Lc2007081623/jr-controller/installer/hikari.png

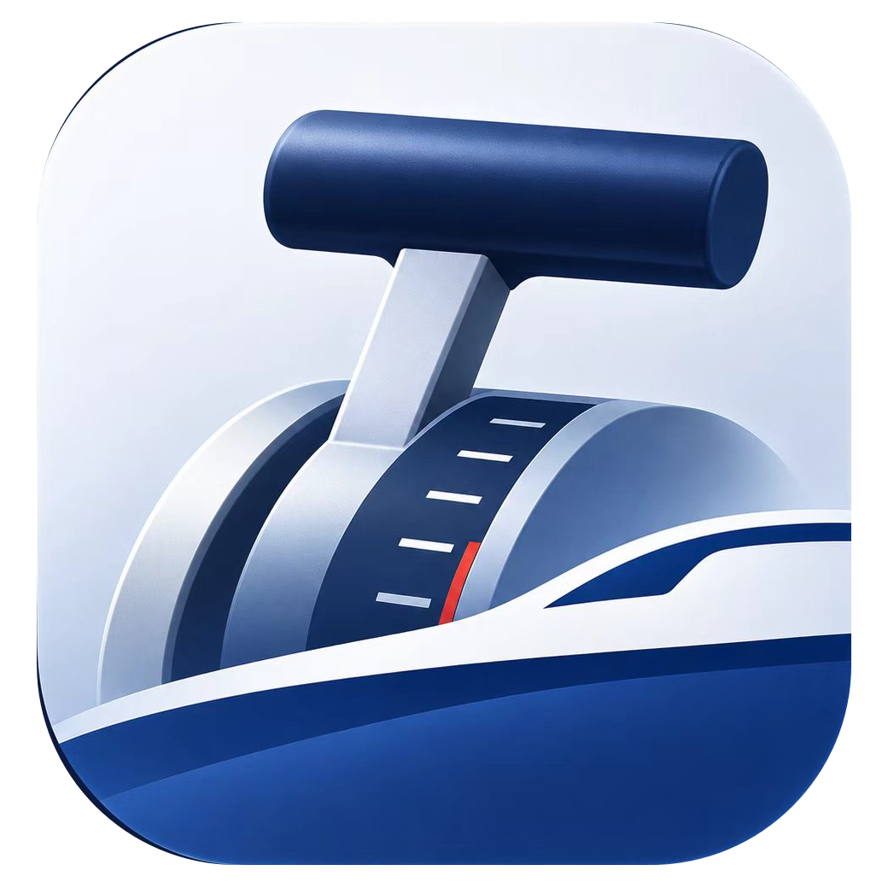
installer/hikari.png
