Lc2007081623/jr-controller/hardware/schematic_images/README.md

# 嘉立创 EDA 原理图录入参考 · A1

日期：2026-10-18。交付为五张 3200×2200 PNG，附同名 SVG。按用户要求不生成 KiCad 工程。

1. `01_主控排针.png`：主控板两列候选排母及网络分配。
2. `02_电源与模拟采样.png`：显示5V输入、载板3.3V去耦、主/备用电位器输入。
3. `03_MAX7219电平转换.png`：SN74AHCT125D全部引脚、五信号显示接口。
4. `04_十二路按钮.png`：12套独立上拉、串联电阻与面板接口。
5. `05_换向与辅助输入.png`：换向、EB触点、本地校准及测试点。

相同蓝色网络名在不同页直接互连，GND为公共地。网络名必须逐字一致；跨页录入时使用全局网络标签。图中芯片按完整14脚矩形表示，嘉立创器件库可使用分门符号，但全部电源、使能和未用引脚仍需连接。

本版供电：主控由板上原生USB供电；显示与电平转换器从J90输入独立稳定5V；两者仅共地。J1.21（主控5Vin）明确留空。载板不连接电脑USB VBUS与独立显示5V，不短接主控IN-OUT或USB-OTG焊盘。若后续需要整机单USB供电，须先核对实物电源路径后修改图纸。

J1/J2针序依据YD系列参考，用户板型号/版本和排针尺寸尚未核对：不要据此直接定PCB封装或下单。J5是载板自定义五信号针序，MAX7219模块的实际输入排列要另行核对。当前电位器为用户选定的RK097N B10K三脚款，图中用电阻轨端/滑动端说明接线。端子、封装与轴尺寸待到货测量，不套用原备选ALPS封装。

原理图图像和BOM中的R/C均以独立器件计数。未接的GPIO与预留连接器可以按需要省装，但不可更改已使用引脚编号。物理常开按钮、电位器和MAX7219模块属于线束外设；BOM列出载板器件，外设另购。

`BOM.csv`是录入器件清单，`connections.csv`是逐引脚网络对照。生成脚本执行了关键连接断言，但这些不是EDA原生ERC，录入后仍需在嘉立创运行电气检查，复核连接器封装与芯片脚号。当前S3固件和硬件链路尚未验证；PC虚拟XInput已验证游戏P1/P3/B5，详见项目README与技术总结。

来源：

- [YD系列厂家参考排针](https://github.com/vcc-gnd/YD-ESP32-S3)
- [SN74AHCT125原厂引脚与电气要求](https://www.ti.com/lit/ds/symlink/sn74ahct125.pdf)
- [MAX7219原厂供电与接口](https://www.analog.com/media/en/technical-documentation/data-sheets/MAX7219-MAX7221.pdf)
- 当前RK097N参数来源：用户提供的B10K三脚款商品截图，阻值与线性需实测。
- 原备选 [ALPS RK09L1120A5F](https://tech.alpsalpine.com/e/products/detail/RK09L1120A5F/)

A1变更：仅更换第一版电位器型号与端子核对说明，4.7kΩ、1kΩ、100nF与GPIO1网络保持不变。商品标注约300°机械角和15mm轴长，不能代替实物尺寸；起止ADC值与N位置均须重新校准。
