Lc2007081623/jr-controller/docs/第一版验收记录.md

# 第一版验收记录

日期：2026-10-21。

Git版本：`v0.1.0`（第一版功能验证）。

用户先确认主档位正常；换向改用XInput X轴并重新加载桥接后，用户确认“验证成功，第一版结束”。记录为第一版功能链路通过，机械回差仍待解决。

## 当前配置

| 项目 | 第一版状态 |
| --- | --- |
| 主控 | 现有ESP32-S3 N16R8板 |
| 电位器 | RK097N B10K，滑动端GPIO3，两端3V3/GND |
| 点阵 | 单块MAX7219，DIN6、CS5、CLK4，沿用已验证供电接线 |
| 显示规则 | 牵引数字；制动数字加右下角LED；空挡N；紧急制动E |
| 校准 | 15点实测，NVS保存；最小相邻间隔12，保留迟滞 |
| 换向按钮 | GPIO10对地，内部上拉，30ms消抖 |
| PC出口 | 同一虚拟Xbox手柄：Y轴主档位，X轴锁存前进F |
| 启用条件 | 连接串口、创建虚拟手柄，物理N后手动启用 |
| 软件验证 | 22项自动测试通过；用户确认游戏档位与换向运行成功 |

默认固件环境为 `s3_uart`；当前临时硬件接线与载板参考图不同，以本记录及[验证步骤](点阵与GPIO3验证.md)为准。本次收尾只更新文档，保留当前程序和设备参数。

## 历史遗留问题：机械回差（已解决）

2026-10-24后续更新：AS5600接入后，用户明确确认机械回差问题已经解决。以下保留第一版结束时的问题与排查计划，不再作为当前待办。

已报告现象：从EB回到空挡，与从P5回到空挡时，ADC读数不同。用户确认机械回差问题仍存在。

后续先记录两个方向回N、停稳后的RAW/ADC和重复性，再检查电位器轴连接间隙、固定与空挡定位。具体间隙来源、停稳后的差值，以及是否需调整空挡识别区间尚未确认。本次没有通过扩大软件空挡区间掩盖该问题。

第一版完成不表示PCB生产文件、全部外设、其他车型或所有异常工况均已验收；各项仍按原有记录保留验证范围。
