Lc2007081623/jr-controller/docs/换向输入核对.md

# 换向输入核对：2026-10-21

用户已经确认电位器主档位正常，GPIO10换向异常。此前将GPIO10映射为键盘↑没有实测通过。现在PC桥接改成同一XInput手柄的左摇杆X轴，Y轴继续保留原档位映射。

## 本地静态观察

目标为用户游戏目录中的 `JREAST_TrainSimulator.exe`，SHA256：`7d04aca24bf4ce2c118afd7861be2f4e6308b0403138325e82b002ae37bb0706`。

以下来自既有反汇编以及本次本地PE/Capstone只读检查，不是REA Evidence。当前没有连接REA工具；其CLI doctor又因包内依赖 `@modelcontextprotocol/client/dist/index.mjs` 缺失而失败，未改客户端配置或游戏文件。

- `0x14008121b`读取XInput状态左摇杆X，归一化后置于xmm1；`0x140081223`读取Y，归一化后置于xmm0，`0x14008124b`调用`0x14007dbc0`。
- 转换器在`0x14007dbfc`保留xmm1，在`0x14007dbff`保留xmm0。后续Y分支正是原有牵引/制动分档。
- `0x14007e328`开始比较X，原厂静态阈值为+0.9与-0.9；跨正阈值生成+1，跨负阈值生成-1，中央生成0。
- `0x14007e36a`至`0x14007e37a`把该值写入输入项7。该分支还更新内部方向键状态0x64/0x65与0x1f0/0x1f1。
- 另一个设备路径`0x140081be0`至`0x140081c4a`把同一方向状态转换为+1、-1、0，并写入同一输入项7。

据此，修正方案通过原生X轴保持换向请求，而非混合键盘事件。当前选择F=+32767，N=0。后续用户确认修正后验证成功，作为运行验证记录；上述静态观察本身不代替运行验证。

## 实现和验证范围

GPIO10固件不变：内部上拉、30ms消抖、按下计数。PC只接受已启用、物理N、新鲜的单次按下；F会锁存并与每次Y报告合并，避免每次改档又把X清零。停止输出、超时或关闭时复位双轴。

自动测试覆盖全部15档下F保持、改换向不扰动主档位、停止/关闭复位、按钮不连发、旧事件不补发。22项测试通过；游戏换向效果由用户实测后确认成功。
