Lc2007081623/jr-controller/hardware/schematic_images/01_主控排针.png

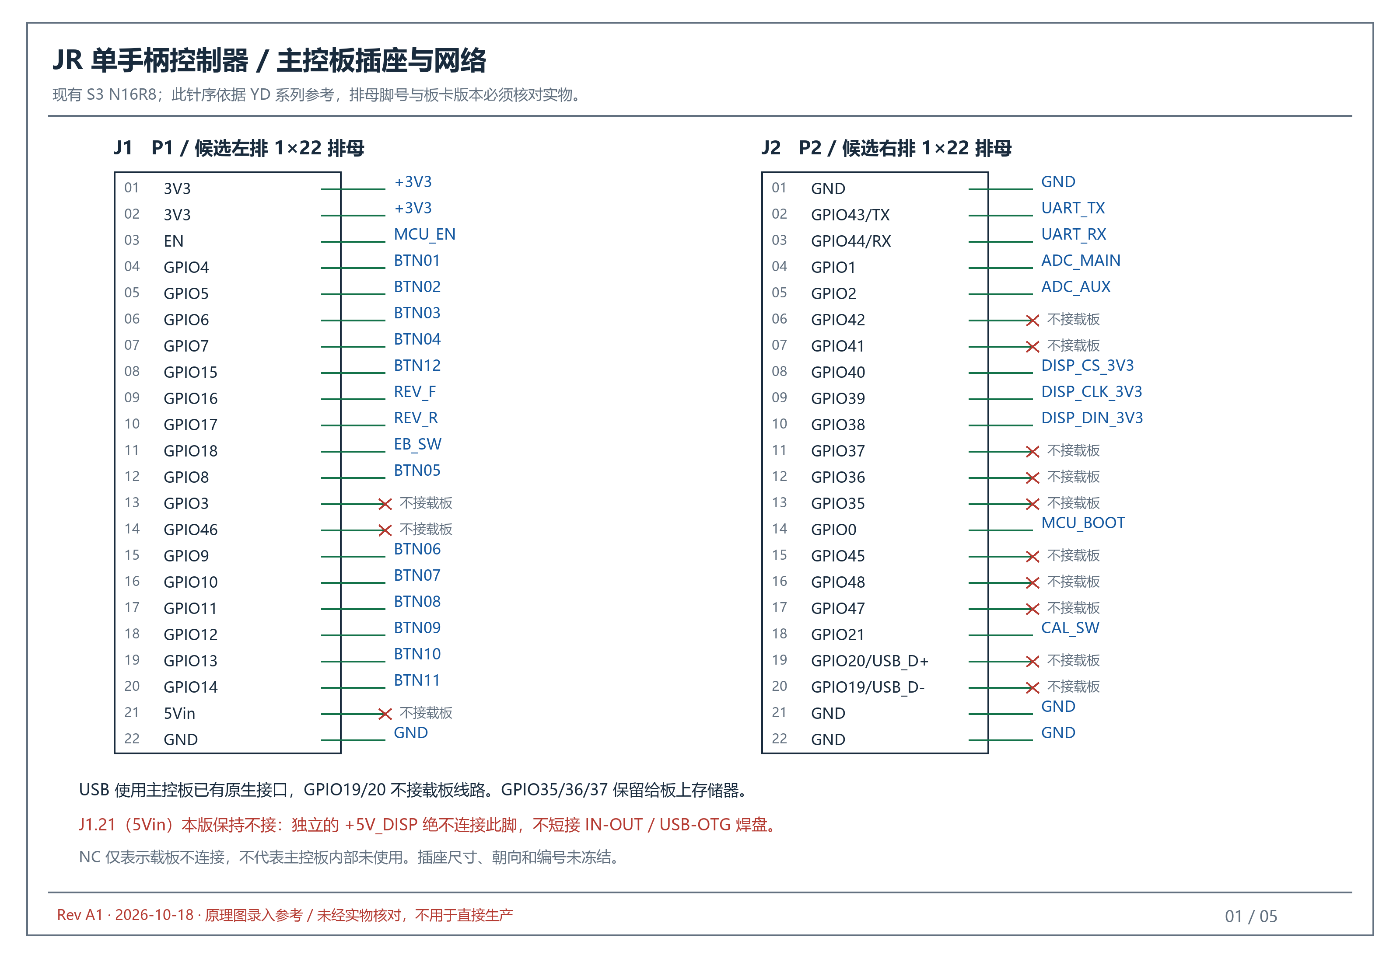
hardware/schematic_images/01_主控排针.png
