Lc2007081623/jr-controller/hardware/schematic_images/02_电源与模拟采样.png

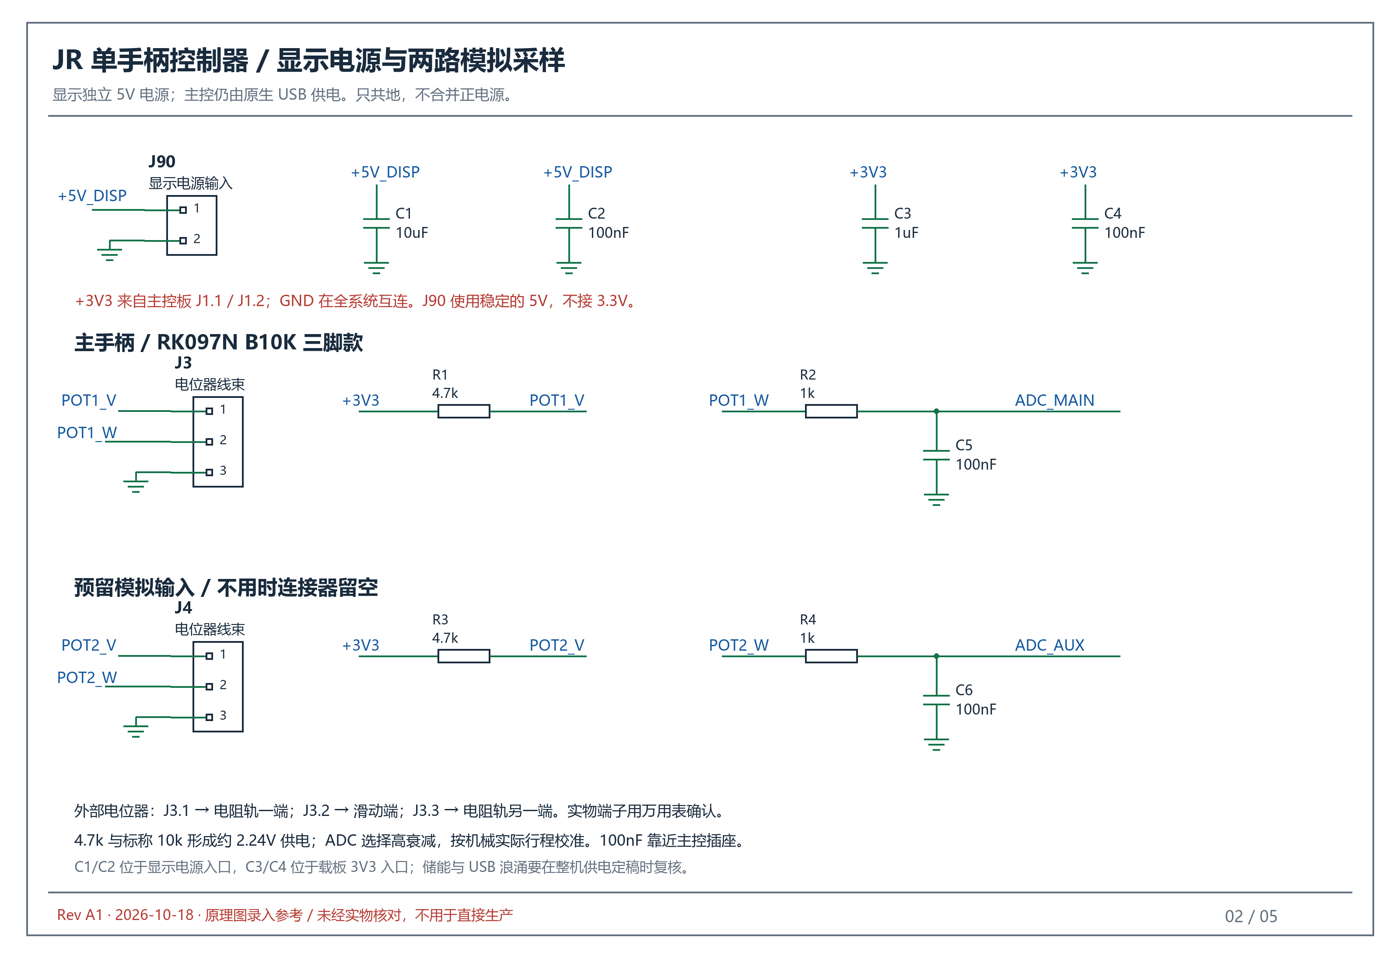
hardware/schematic_images/02_电源与模拟采样.png
