Lc2007081623/jr-controller/hardware/schematic_images/03_MAX7219电平转换.png

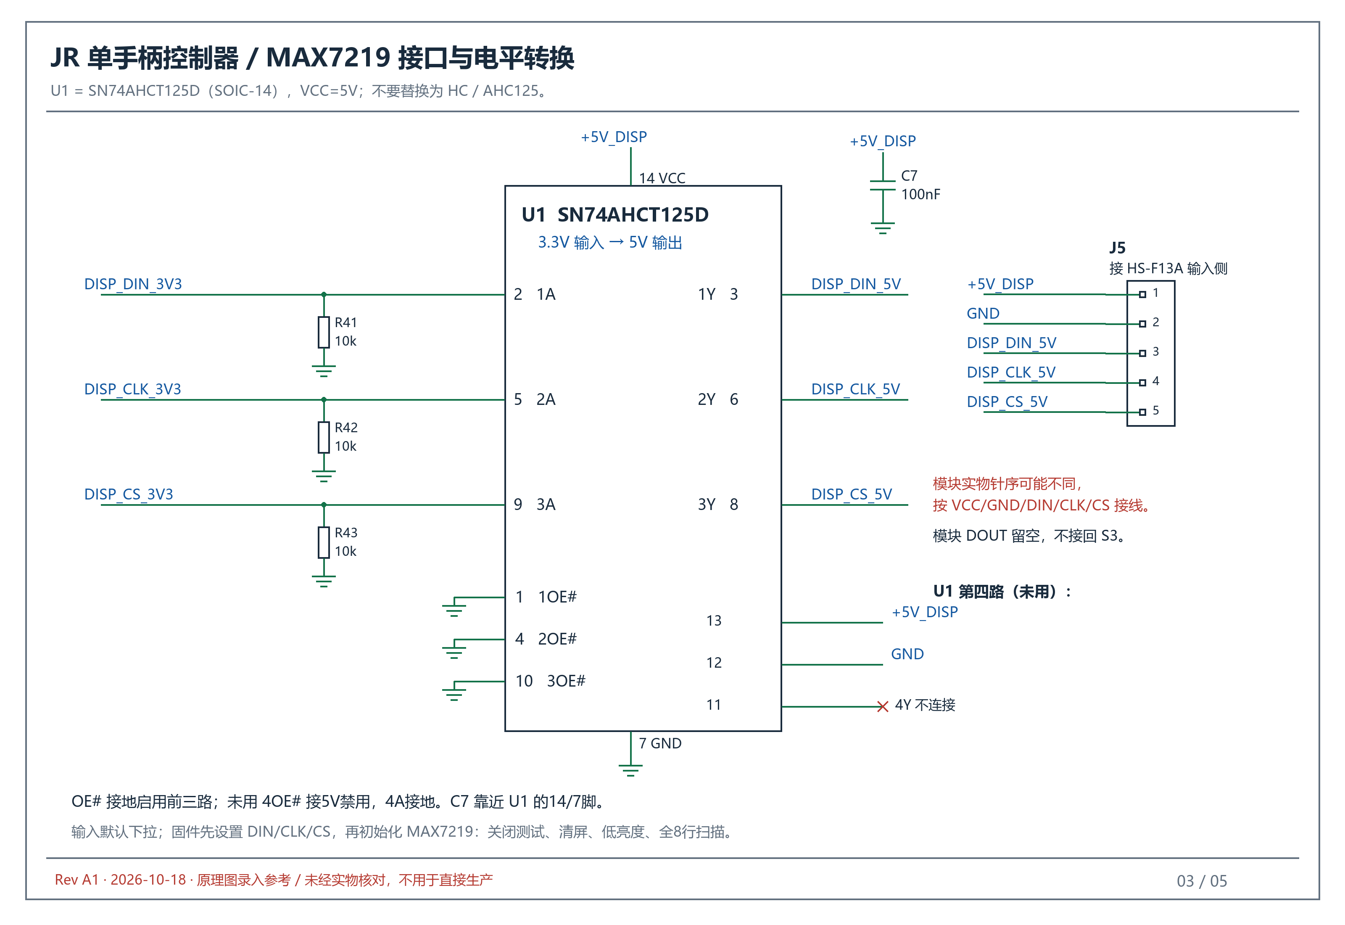
hardware/schematic_images/03_MAX7219电平转换.png
