Lc2007081623/jr-controller/hardware/schematic_images/04_十二路按钮.png

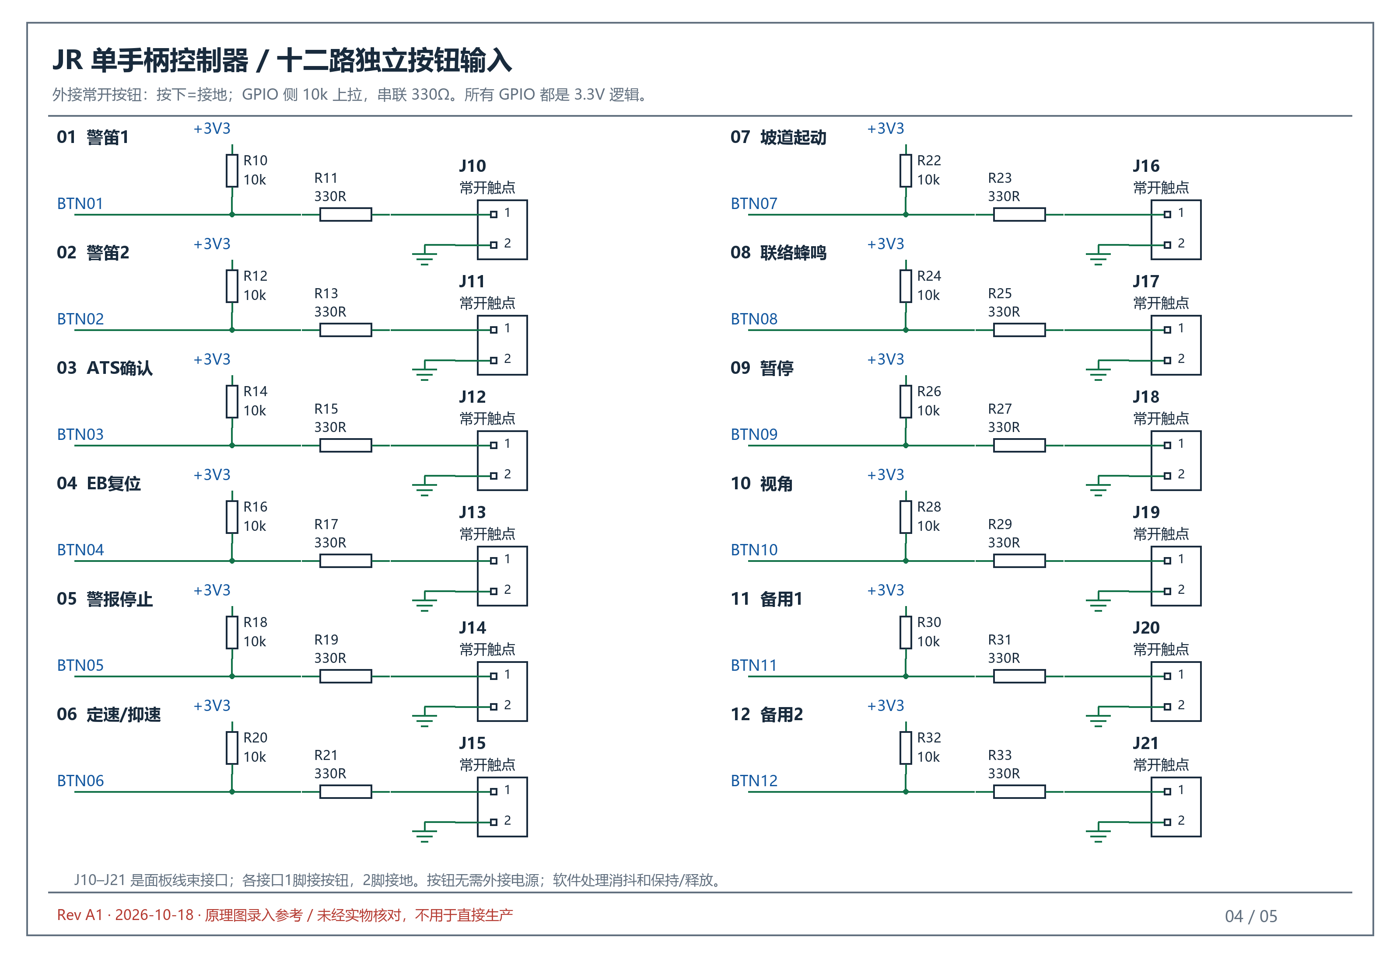
hardware/schematic_images/04_十二路按钮.png
