Lc2007081623/jr-controller/hardware/schematic_images/05_换向与辅助输入.png

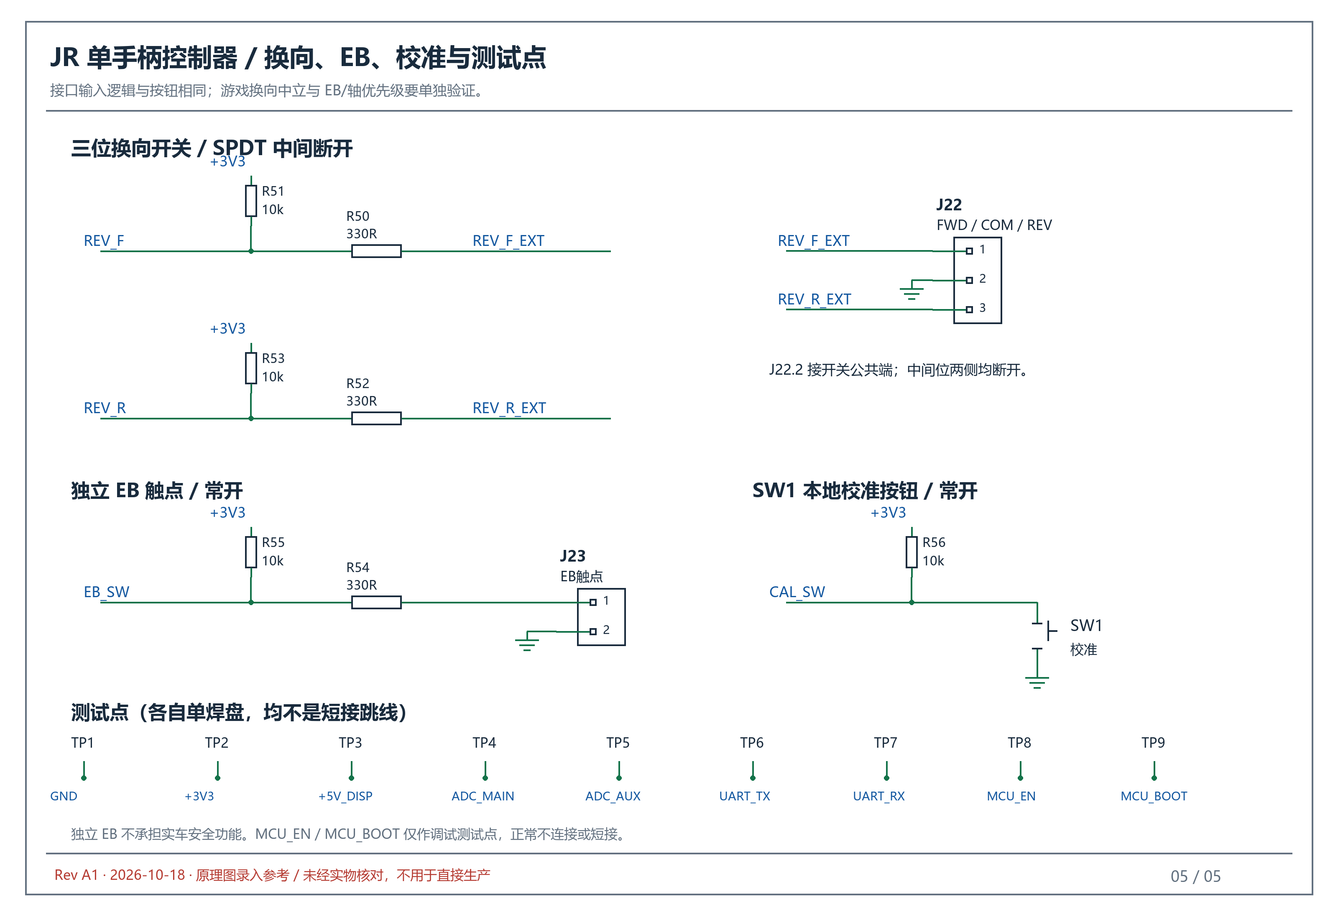
hardware/schematic_images/05_换向与辅助输入.png
