Lc2007081623/jr-controller/hardware/schematic_images/connections.csv

Reference | Pin | Net
J1 | 1 | +3V3
J1 | 2 | +3V3
J1 | 3 | MCU_EN
J1 | 4 | BTN01
J1 | 5 | BTN02
J1 | 6 | BTN03
J1 | 7 | BTN04
J1 | 8 | BTN12
J1 | 9 | REV_F
J1 | 10 | REV_R
J1 | 11 | EB_SW
J1 | 12 | BTN05
J1 | 13 | NC
J1 | 14 | NC
J1 | 15 | BTN06
J1 | 16 | BTN07
J1 | 17 | BTN08
J1 | 18 | BTN09
J1 | 19 | BTN10
J1 | 20 | BTN11
J1 | 21 | NC
J1 | 22 | GND
J2 | 1 | GND
J2 | 2 | UART_TX
J2 | 3 | UART_RX
J2 | 4 | ADC_MAIN
J2 | 5 | ADC_AUX
J2 | 6 | NC
J2 | 7 | NC
J2 | 8 | DISP_CS_3V3
J2 | 9 | DISP_CLK_3V3
J2 | 10 | DISP_DIN_3V3
J2 | 11 | NC
J2 | 12 | NC
J2 | 13 | NC
J2 | 14 | MCU_BOOT
J2 | 15 | NC
J2 | 16 | NC
J2 | 17 | NC
J2 | 18 | CAL_SW
J2 | 19 | NC
J2 | 20 | NC
J2 | 21 | GND
J2 | 22 | GND
J90 | 1 | +5V_DISP
J90 | 2 | GND
C1 | 1 | +5V_DISP
C1 | 2 | GND
C2 | 1 | +5V_DISP
C2 | 2 | GND
C3 | 1 | +3V3
C3 | 2 | GND
C4 | 1 | +3V3
C4 | 2 | GND
J3 | 1 | POT1_V
J3 | 2 | POT1_W
J3 | 3 | GND
R1 | 1 | +3V3
R1 | 2 | POT1_V
R2 | 1 | POT1_W
R2 | 2 | ADC_MAIN
C5 | 1 | ADC_MAIN
C5 | 2 | GND
J4 | 1 | POT2_V
J4 | 2 | POT2_W
J4 | 3 | GND
R3 | 1 | +3V3
R3 | 2 | POT2_V
R4 | 1 | POT2_W
R4 | 2 | ADC_AUX
C6 | 1 | ADC_AUX
C6 | 2 | GND
U1 | 2 | DISP_DIN_3V3
U1 | 3 | DISP_DIN_5V
R41 | 1 | DISP_DIN_3V3
R41 | 2 | GND
U1 | 5 | DISP_CLK_3V3
U1 | 6 | DISP_CLK_5V
R42 | 1 | DISP_CLK_3V3
R42 | 2 | GND
U1 | 9 | DISP_CS_3V3
U1 | 8 | DISP_CS_5V
R43 | 1 | DISP_CS_3V3
R43 | 2 | GND
U1 | 1 | GND
U1 | 4 | GND
U1 | 10 | GND
U1 | 14 | +5V_DISP
U1 | 7 | GND
C7 | 1 | +5V_DISP
C7 | 2 | GND
J5 | 1 | +5V_DISP
J5 | 2 | GND
J5 | 3 | DISP_DIN_5V
J5 | 4 | DISP_CLK_5V
J5 | 5 | DISP_CS_5V
U1 | 13 | +5V_DISP
U1 | 12 | GND
U1 | 11 | NC
R10 | 1 | +3V3
R10 | 2 | BTN01
R11 | 1 | BTN01
R11 | 2 | BTN01_EXT
J10 | 1 | BTN01_EXT
J10 | 2 | GND
R12 | 1 | +3V3
R12 | 2 | BTN02
R13 | 1 | BTN02
R13 | 2 | BTN02_EXT
J11 | 1 | BTN02_EXT
J11 | 2 | GND
R14 | 1 | +3V3
R14 | 2 | BTN03
R15 | 1 | BTN03
R15 | 2 | BTN03_EXT
J12 | 1 | BTN03_EXT
J12 | 2 | GND
R16 | 1 | +3V3
R16 | 2 | BTN04
R17 | 1 | BTN04
R17 | 2 | BTN04_EXT
J13 | 1 | BTN04_EXT
J13 | 2 | GND
R18 | 1 | +3V3
R18 | 2 | BTN05
R19 | 1 | BTN05
R19 | 2 | BTN05_EXT
J14 | 1 | BTN05_EXT
J14 | 2 | GND
R20 | 1 | +3V3
R20 | 2 | BTN06
R21 | 1 | BTN06
R21 | 2 | BTN06_EXT
J15 | 1 | BTN06_EXT
J15 | 2 | GND
R22 | 1 | +3V3
R22 | 2 | BTN07
R23 | 1 | BTN07
R23 | 2 | BTN07_EXT
J16 | 1 | BTN07_EXT
J16 | 2 | GND
R24 | 1 | +3V3
R24 | 2 | BTN08
R25 | 1 | BTN08
R25 | 2 | BTN08_EXT
J17 | 1 | BTN08_EXT
J17 | 2 | GND
R26 | 1 | +3V3
R26 | 2 | BTN09
R27 | 1 | BTN09
R27 | 2 | BTN09_EXT
J18 | 1 | BTN09_EXT
J18 | 2 | GND
R28 | 1 | +3V3
R28 | 2 | BTN10
R29 | 1 | BTN10
R29 | 2 | BTN10_EXT
J19 | 1 | BTN10_EXT
J19 | 2 | GND
R30 | 1 | +3V3
R30 | 2 | BTN11
R31 | 1 | BTN11
R31 | 2 | BTN11_EXT
J20 | 1 | BTN11_EXT
J20 | 2 | GND
R32 | 1 | +3V3
R32 | 2 | BTN12
R33 | 1 | BTN12
R33 | 2 | BTN12_EXT
J21 | 1 | BTN12_EXT
J21 | 2 | GND
R50 | 1 | REV_F
R50 | 2 | REV_F_EXT
R51 | 1 | +3V3
R51 | 2 | REV_F
J22 | 1 | REV_F_EXT
R52 | 1 | REV_R
R52 | 2 | REV_R_EXT
R53 | 1 | +3V3
R53 | 2 | REV_R
J22 | 3 | REV_R_EXT
J22 | 2 | GND
R54 | 1 | EB_SW
R54 | 2 | EB_EXT
R55 | 1 | +3V3
R55 | 2 | EB_SW
J23 | 1 | EB_EXT
J23 | 2 | GND
R56 | 1 | +3V3
R56 | 2 | CAL_SW
SW1 | 1 | CAL_SW
SW1 | 2 | GND
TP1 | 1 | GND
TP2 | 1 | +3V3
TP3 | 1 | +5V_DISP
TP4 | 1 | ADC_MAIN
TP5 | 1 | ADC_AUX
TP6 | 1 | UART_TX
TP7 | 1 | UART_RX
TP8 | 1 | MCU_EN
TP9 | 1 | MCU_BOOT
