Lc2007081623/jr-controller/装配体1.SLDASM

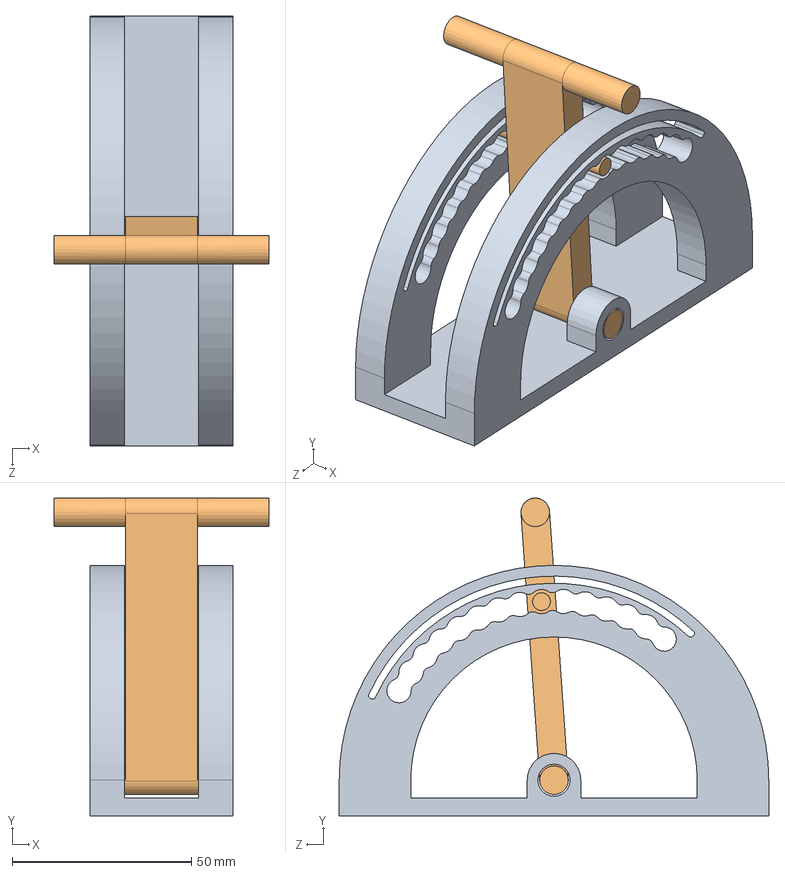
[picture p7: CAD file, 2026-10-14]
装配体1.SLDASM
60.0 x 88.8 x 120.0 mm
零件1
零件2^装配体1
