Lc2007081623/jr-controller/v2分度盘子.SLDPRT

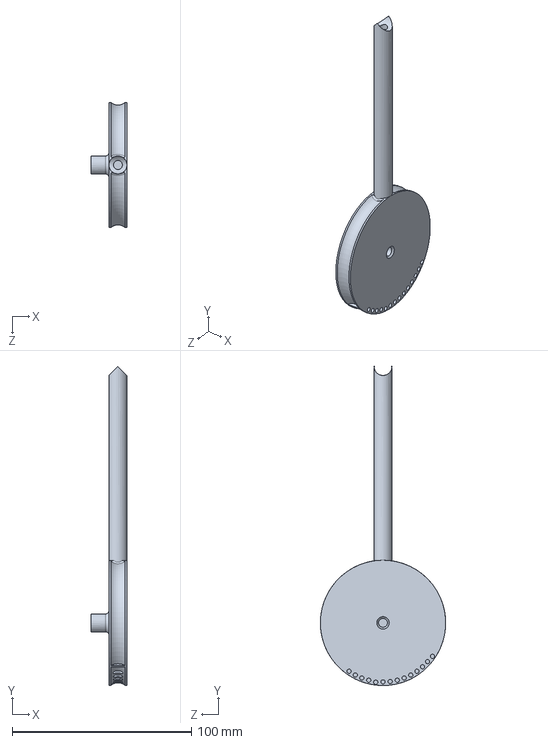
[picture p8: CAD file, 2026-10-24]
v2分度盘子.SLDPRT
20.0 x 178.2 x 70.0 mm
