Lc2007081623/jr-controller/基座.SLDPRT

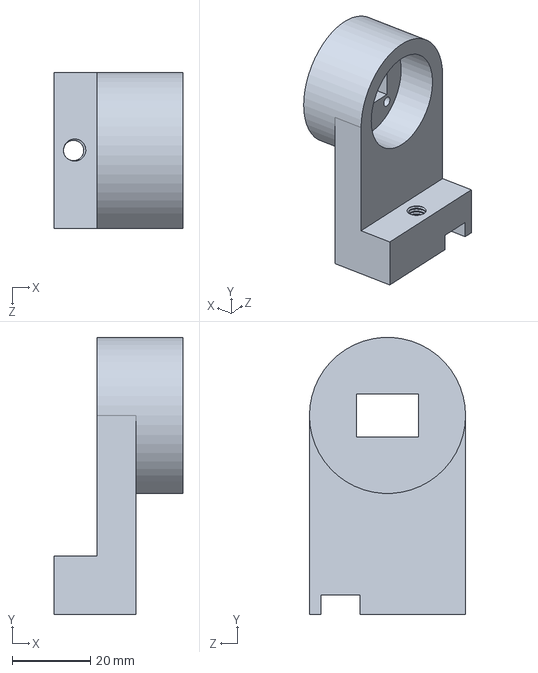
[picture p9: CAD file, 2026-10-24]
基座.SLDPRT
33.0 x 71.0 x 40.0 mm
