Lc2007081623/jr-controller/把手.SLDPRT

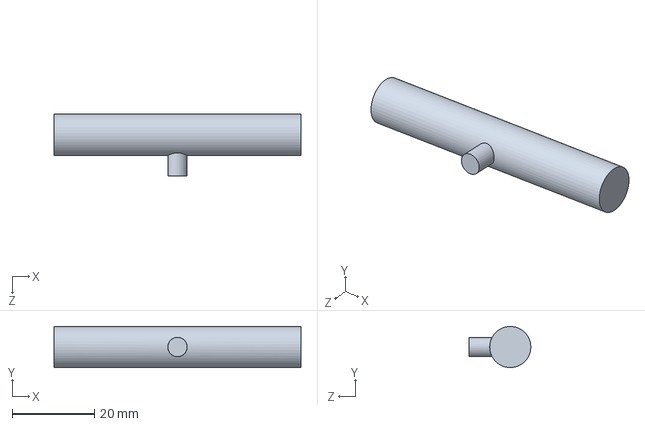
[picture p10: CAD file, 2026-10-24]
把手.SLDPRT
60.0 x 9.97 x 15.0 mm
