Lc2007081623/jr-controller/后挡.SLDPRT

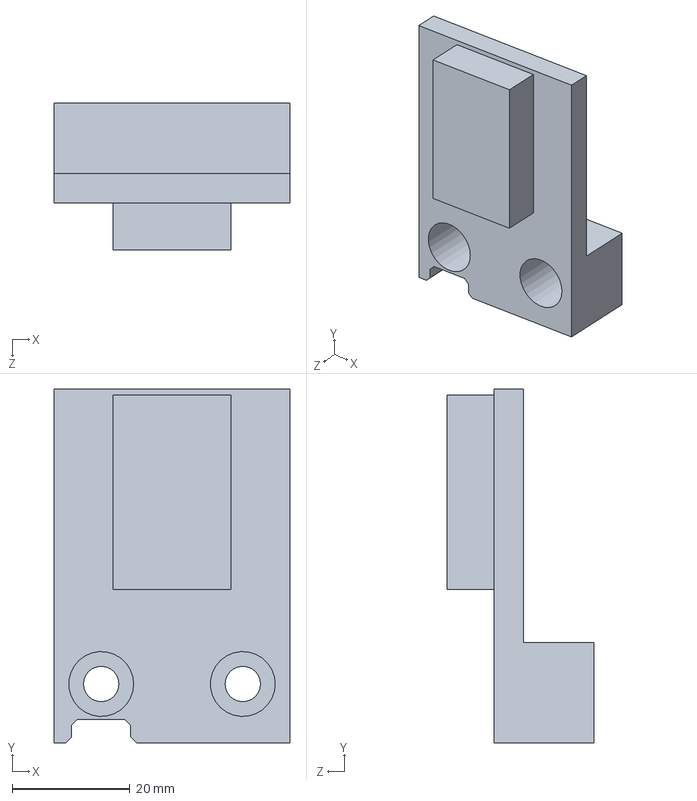
[picture p11: CAD file, 2026-10-21]
后挡.SLDPRT
40.0 x 60.0 x 25.0 mm
