Lc2007081623/jr-controller/零件1.SLDPRT

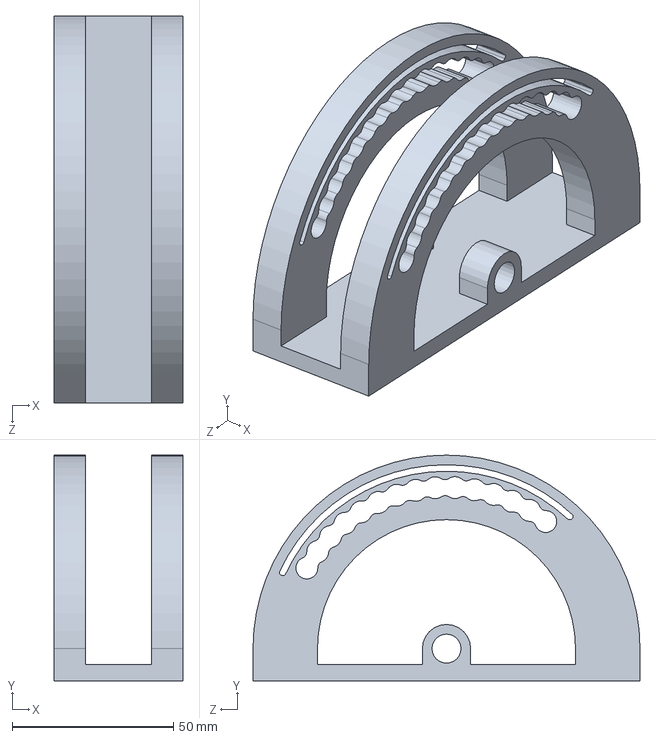
[picture p12: CAD file, 2026-10-14]
零件1.SLDPRT
40.0 x 70.0 x 120.0 mm
