Lc2007081623/jr-controller/(list of files, cad)

Other CAD files:
v2分度盘子.STL
后挡.STL
基座.STL
把手.STL
装配体1.SLDPRT
装配体1.STL
