Lc2007081623/jr-controller/installer/train_crew_guide.html

# JR Controller · TRAIN CREW

在 JR Controller 的游戏模式选择 TRAIN CREW（官方接口），再启动游戏。在游戏设置 → 操作设置中启用外部设备输入输出。菜单选项继续用鼠标或键盘操作。

如果程序提示接口未就绪，请先退出 TRAIN CREW，等控制器程序就绪后再启动游戏。本机遇到过游戏先启动时SDK无法打开共享内存的情况。

主手柄、换向器和按钮沿用控制器中保存的校准，连接后立即跟随当前位置。进入游戏前请先置空挡，松开按钮。

实体操作 | TRAIN CREW
P1～P5 / N | 对应牵引档 / 空挡
B1～B6 | 对应常用制动档
B7、B8 | B6（游戏常用最大制动）
EB | 紧急制动
F / N / R | 前进 / 空挡 / 后退；游戏的车辆联锁仍生效
A / B | 气笛 / 电笛
X / Y | EB装置警报确认 / 联络蜂鸣

游戏当前标准车辆为六段常用制动，本模式将 B7/B8 保持在常用最大，不会把它们当作紧急制动。双手柄与电磁直通制动车辆尚需分别验证。

退出、校准或串口数据失效时发送紧急制动，并释放方向与按钮；桥接程序超过1秒收不到桌面程序的数据时也发送相同状态。

本模式使用 TRAIN CREW 官方控制器开发接口 (https://acty-soft.com/traincrew/controller/)，不修改游戏程序，不需要 Steam Input 或额外虚拟手柄。
