Lc2007081623/jr-controller/CHANGELOG.md

# 版本记录

## 1.1.4 — 2026-11-11

- 「软件设置 → N 比例模块」支持读取和保存 Odoriko 的 P 档加速、N 档滑行掉速和 B 档减速参数。
- Hidari 2 进入模型模式时，上位机显示模式并暂停游戏输入。安装包内置 Hidari 2 固件 1.2.4，模型模式下退出 EB 后回主手柄 N 即可恢复牵引。

## 1.1.3 — 2026-11-10

- 四个实体按键可分别映射为键盘键或 Xbox 360 按键，也可保留游戏默认或禁用。Xbox 360 映射在 JR EAST（Xbox）模式生效。
- 内置 hidari1 和 hidari2 固件更新包。软件按设备上报的型号选包，核对设备编号、分区和固件校验值后更新。

## 1.1.2 — 2026-11-09

- 在 JR EAST（Xbox）模式新增「启动 JR EAST」，记住 Steam 或游戏 EXE 入口，等控制器输出就绪再启动游戏。
- 游戏已运行时提示退出重试，避免错过游戏启动时的手柄识别。
- 安装窗口提示安装前退出 360 等杀毒软件，完成后重新开启。

## 1.1.1 — 2026-11-08

- 本代 ESP32-C3 + AS5600 硬件命名为 **Hikari 1**。
- 主界面放大硬件名称、连接状态、串口、角度和固件信息。
- 使用裁剪后的新图标，桌面和开始菜单快捷方式直接引用安装目录中的 ICO。

下载 Windows 交付 ZIP 可同时取得安装程序与使用说明，也可单独下载安装程序。固件更新包版本为 1.1.0。

## 1.1.0 — 2026-11-08

- 新增软件设置、绿色和深色主题，以及四种游戏模式各自的接入说明。
- 软件可查询 GitHub 最新正式发布版，并打开下载页面。
- LED 点阵可调整亮度、旋转、开关和各档位 8×8 图案。配置保存在本机，设备连接后自动应用，需要新版固件。
- 新增默认关闭的本机只读 HTTP 接口。启用后可读取档位、换向器和四键状态，默认地址为 `http://127.0.0.1:8765/v1/state`。
- 主界面显示硬件板型、传感器和固件版本。内置配套 C3 点阵版固件更新包，检查芯片编号和分区，仅写应用区以保留校准。
- 84 项 Python 测试、四模式打包自检、C3 与两种 S3 固件构建均已通过。实物刷写与点阵显示仍待验证。

下载交付 ZIP 可同时取得安装程序与使用说明。也可单独下载 `JRControllerSetup.exe`，安装后从软件中打开说明。

## 1.0.0 — 2026-11-06

- 将已实机验证的 0.6.0 确立为 v1 主版本，功能与控制器映射保持一致。
- 更新程序、安装包和使用说明的版本标识。

## 0.6.0 — 2026-11-06

- 新增 TRAIN CREW 官方接口模式，使用官方2025-11-16 SDK及独立.NET桥接进程，直接输出档位、换向、气笛、电笛、EB确认和联络蜂鸣。
- 实体B1～B6对应游戏常用制动；B7/B8保持B6，EB独立输出。暂停、失联、退出时释放方向与按钮并紧急制动，桥接进程有1秒心跳超时保护。
- 安装包包含桥接程序、获准随软件再分发的未修改官方DLL及离线说明；无需刷写固件或配置Steam Input。84项Python测试通过。
- 正式用户版安装与四模式自检通过；TRAIN CREW 1261次列车实际状态回读及实体操作验证完成。用户确认档位、换向及四按钮全部正常。其他车型仍需另行验证。

## 0.5.0 — 2026-11-06

- 新增 BVE 5/6 模式及原生输入插件，复用现有串口、校准与故障判断，无需修改固件或模拟逐档按键。
- 按车型范围输出绝对档位，支持单/双手柄、F/N/R、四按钮；桥接失联或暂停输出时释放按键并紧急制动。
- 用户确认 BVE 6 内房线 N/P1/P3/B5/EB、BVE 5 京成线相同档位及 F/N/R 正常。四按钮线路效果尚待逐项确认。
- 正式用户程序与完整离线安装包已升级；安装时可选择 BVE 5/6 游戏目录，按架构复制插件。随包附带两套插件和离线 BVE 说明。79 项 Python 测试及两套插件测试通过。构建与验证见 docs/BVE接入验证.md。

## 开发进度 — 2026-11-05（应用版本仍为 0.4.1）

- Steam JR EAST 体验版 1.0.1.551 应用官方 Tsukasa Mascon 布局后，用户确认主手柄与 F/N/R 正常；复用 Xbox 后端，无需修改固件。更新离线使用说明源文件，现有安装包尚未重新打包。
- 补充 Arduino IDE 可直接打开的 ESP32-C3 草图、源码导出脚本与上传说明；ESP32 Arduino core 3.3.10 编译、实物烧录校验已通过。
- BVE5.8／6 处于可行性确认阶段，尚未实现专用输入插件，不计入已支持游戏。

## 0.4.1 — 2026-11-02

- 完整离线安装向导加入系统检查、驱动修复、程序安装、两个游戏模式的中立输出自检与明确重启提示。
- 随包附带离线安装、USB 连接、校准、游戏模式及故障处理说明，主窗口增加“使用说明”入口；安装失败可直接打开日志。
- 自检无需硬件、不打开串口；新增独立 EXE 自检入口。74 项测试通过，全新电脑的安装与重启需另机验证。

## 0.4.0 — 2026-11-02

- 用户确认 Pro Rz 换向器修正方案验证成功，集成至正式 RUNNING TRAIN 模式：F=128、N=0、R=255。
- 按用户要求取消启动回 N、松开按钮及 300ms 等待；取消仅主手柄 N 可换向。有效数据到达后立即跟随当前档位与方向，保留故障释放和校准暂停。
- 主窗口更新为控制台布局，增加方向高亮和版本标识；更新离线安装包，沿用 ViGEmBus 1.22.0。63 项测试通过。

## Pro 换向器研究分支 — 2026-11-02

- 新增独立的 `33DD:0006` Pro 身份探测与 X/Z/Rz 候选轴试验，标明 DS4 描述符和未验证映射；不改变正式游戏模式。59 项测试通过。
- Windows 已枚举 Pro 身份，实体 COM7 输入就绪；游戏内识别和换向效果仍需实测。

## 未发布 — 2026-11-01

- 0.3.2：正式窗口集成 RUNNING TRAIN（ZUIKI）与 JR EAST（Xbox）模式选择，保存本机选择；切换释放旧设备并重新等待回 N。RUNNING TRAIN 换向器保持待解决，暂不发送方向操作。56 项测试通过。

- 0.3.1：新增四按钮 A/B/X/Y 学习、独立 NVS 保存，拒绝重复和同时按下的采集；退出校准会取消未保存的学习。
- 主窗口改为卡片式实时面板，校准中心按主手柄／换向器／按钮／诊断日志分栏；52 项测试通过，新 C3 固件已烧录。
- 修复重复启动时因单实例锁权限不足导致 WinError 5 崩溃；改为最小访问权限并恢复已有窗口，已验证打包 EXE 重复启动退出码 0。
- 0.3.1 时 RUNNING TRAIN 原生虚拟 ZUIKI 的主手柄和按钮已获用户确认；当时留在独立试验脚本，0.3.2 已集成主手柄和按钮。

- 新增 Windows x64 离线安装 EXE，包含运行环境、已验签的 ViGEmBus 1.22.0 驱动、桌面入口、登录启动和卸载。
- 新增简化窗口，自动发现 C3 串口、创建虚拟手柄、断线重连；校准有效且主手柄、换向器回 N 稳定 300ms 后自动启用。
- 校准窗口打开时暂停游戏输入，关闭后自动恢复连接；保留完整校准工具。
- 40 项测试通过，打包程序已在本机自动读取 COM7 和板上校准；无驱动新电脑的首次安装仍需另机验证。

- 新增 ESP32-C3 4MB 原生 USB 串口环境，按用户载板接入 AS5600 和 3V3 点阵。
- 三档开关 GPIO7/F、断开/N、GPIO1/R；四个对地按钮 GPIO0/10/20/21 映射 XInput A/B/X/Y，停用或超时释放。
- 新增换向器 F/N/R 三点学习与独立 NVS 保存，重复触点或非断开空挡拒绝保存，校准期间停用输出。
- 桥接显示 C3 接线与输入状态；手柄和换向开关置 N 后启用，主手柄 N 时切换 F/N/R，异常触点停用输出。
- 保留 S3 按钮换向和电位器环境；32 项软件测试通过。C3 后退游戏效果及逐档实测待用户验证。

## v0.2.0 — 2026-10-24

AS5600已接入完整控制器，用户反馈接入效果正常；主控仍为现有ESP32-S3。

- 新增AS5600 I²C读取，当前SDA=GPIO7、SCL=GPIO15；检查通信与磁场有效性。
- 新增独立角度验证固件、实时角度窗口和完整控制器编译环境。
- 校准支持圆周均值、双向行程与跨0°展开，采用独立NVS存储，不沿用电位器校准。
- 桥接窗口识别传感器类型，磁场异常或通信失败时停用输出，恢复后手动启用。
- 继续使用MAX7219点阵、GPIO10换向按钮与XInput双轴控制，保留第一版电位器配置。
- 更新分度盘、基座并加入把手机械模型与验证文档。
- 24项自动测试、监视器自检、两种控制器固件编译通过；AS5600固件已烧录，板上角度自检和实机读取通过。

后续验证（2026-10-24）：用户确认机械回差问题已经解决，从当前待办移除。

待完成：记录逐档游戏验证，以及后续ESP32-C3迁移。

## v0.1.0 — 2026-10-21

第一版功能验证完成，用户确认游戏主档位及换向成功。

- ESP32-S3读取GPIO3电位器，支持15点机械卡位校准、NVS保存、滤波和迟滞。
- 使用MAX7219单色点阵：牵引数字，制动数字加右下角LED，空挡N、紧急制动E。
- GPIO10对地按钮经消抖选择前进；PC虚拟XInput手柄使用X轴保持换向、Y轴输出主档位。
- 提供串口监看、校准与手动启用窗口；超时或停用时复位双轴，不自动重新启用。
- 保留独立点阵测试与旧OLED固件环境，更新参考图纸、机械模型和验收文档。
- 22项自动测试通过，固件编译与烧录通过。

待解决：机械回差导致从不同方向回空挡的ADC不同。PCB生产文件、其他外设及其他车型验证不属于本次完成范围。
