Lc2007081623/jr-controller/(commit log)

2026-11-02 feat: integrate C3 calibration and RUNNING TRAIN output in desktop app
2026-11-02 experiment: probe Mascon Pro identity and reverser axis candidates
2026-11-02 fix: report physical input and arming reason in Pro probe
2026-11-02 feat: add complete offline installation and driver verification flow
2026-11-05 docs: sync Steam JRETS validation and Arduino firmware workflow
2026-11-10 Release v1.1.3 with button mapping and Hidari firmware support
